JunjianChi/ISCAS_2025_Insole/3d_model/esp32-firebeetle_dfr0478v4_quick-1.snapshot.1/DFR0478V4.png

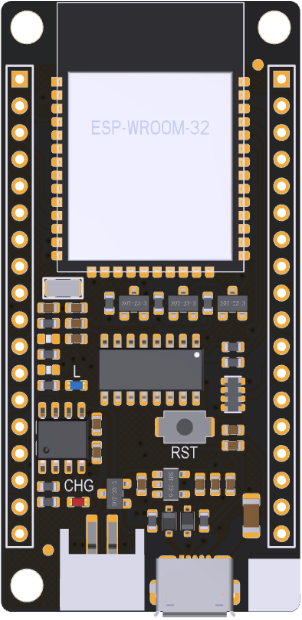
3d_model/esp32-firebeetle_dfr0478v4_quick-1.snapshot.1/DFR0478V4.png
