JunjianChi/ISCAS_2025_Insole/Live_demo_Insole_final.pdf

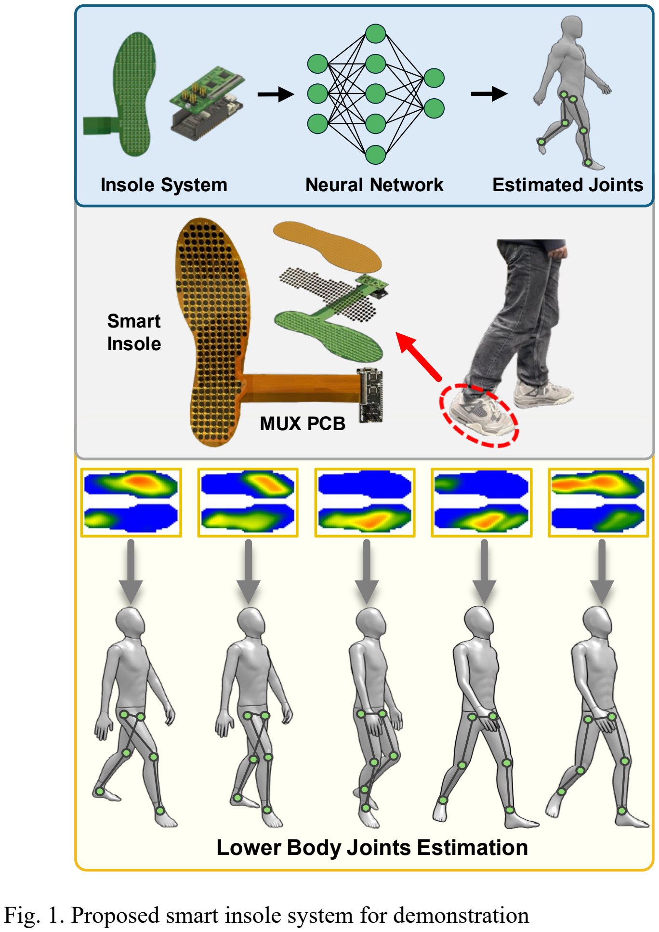
[picture p2: figure]
Insole System; Neural Network; Estimated Joints; Lower Body Joints Estimation; Smart Insole; MUX PCB

Fig. 1. Proposed smart insole system for demonstration

# Live Demonstration: A High-Resolution Plantar Insole System for Lower Body Estimation

JunJian Chi, Qingyu Zhang, Zibo Zhang, Andreas Demosthenous and Yu Wu

Department of Electronic and Electrical Engineering, University College London, Torrington Place, London WC1E 7JE, UK

Email: junjian.chi.22@ucl.ac.uk, yu.wu.09@ucl.ac.uk

Abstract—This work presents a high-resolution plantar
pressure measurement system designed to capture detailed foot information for gait analysis. After training, the customized regression model can estimate lower body joints positions in real-time using foot pressure data. The demonstration will feature a UK size 8 insole, equipped with 253 resistive pressure sensors wirelessly connected to the server. Visitors will have the opportunity to experience walking with the insole, observing the plantar force distribution displayed and lower body joints as predicted by the model on the computer.
I. INTRODUCTION
Gait analysis has been widely carried out with wearable sensors to monitor an individual’s health conditions [1]. The changes of plantar forces distribution during various phases of a walking cycle can identify different body postures and motions. Several researchers have pointed out that these subtle force variations are essential for the prediction of lower body joints movement [2]. Current plantar pressure measurement systems mostly use a limited number of large sensors [3] and tends to neglect details in certain foot areas. Using a denser array of smaller sensors to predict lower limb joint motion has the potential for applications in rehabilitation and sports performance optimisation, though its potential has been relatively underestimated in existing methods [4].
In this demonstration, we present a high-resolution smart insole hardware system, consisting of flexible printed circuit board (FPC) base and a Kapton top layer that sandwiches the circular piezoresistive material (Velostat) as shown in Fig. 1. It can achieve visualization of comprehensive pressure heatmaps on the computer at a fast wireless transmission rate. Combining a customized Convolutional Neural Networks (CNNs) and Long Short-Term Memory (LSTM) model, it can predict six lower body joint landmark positions (left hip, right hip, left knee, right knee, left foot, and right foot) with a high coefficient of determination [5].

II. DEMONSTRATION SETUP AND VISITOR EXPERIENCE
A 253-resolution wireless insole system, an RGB camera and a laptop for predicting lower body estimation from the transmitted pressure data is provided in the demonstration. This demonstration allows visitors to wear the smart insole and observe their lower limb joints prediction through the laptop's GUI. To enhance the visitors' understanding of how the pressure-sensitive insole predicts lower limb dynamics, a classic human skeleton recognition algorithm using an RGB camera will be set up as a comparison group. After completing the experience with the control group, users will wear the smart insole and can observe their lower limb movements in real-time on the GUI. Additionally, a heatmap displaying the plantar pressure distribution will be shown as a reference for visitors.

REFERENCES
[1] Wang, Y. Kim, H. Shin, and S. D. Min, “Preliminary clinical application of textile insole sensor for hemiparetic gait pattern analysis,” Sensors, vol. 19, no. 18, Art. no. 18, Jan. 2019.
[2] Tao, T. Liu, R. Zheng, and H. Feng, “Gait analysis using wearable sensors,” Sensors (Basel), vol. 12, no. 2, pp. 2255–2283, Feb. 2012.
[3] M. Santos, B. B. Gomes, M. A. Neto, and A. M. Amaro, “A systematic review of insole sensor technology: Recent studies and future directions,” Applied Sciences, vol. 14, no. 14, Art. no. 14, Jan. 2024.
[4] A. Ramirez-Bautista, J. A. Huerta-Ruelas, S. L. Chaparro-Cardenas, and A. Hernandez-Zavala, “A review in detection and monitoring gait disorders using in-shoe plantar measurement systems,” IEEE Rev Biomed Eng, vol. 10, pp. 299–309, 2017.
[5] J. Chi, Q. Zhang, Z. Zhang, A. Demosthenous, and Y. Wu “High-Resolution Plantar Pressure Insole System for Enhanced Lower Body Biomechanical Analysis,” submitted to 2025 IEEE Int. Symp. Circuits Syst. (ISCAS 2025, Submission ID: 2728)

This work was supported by the Rosetrees Trust, under grant reference: UCL-IHE-HA\1.
