JunjianChi/ISCAS_2025_Insole/PCB/Insole_ver1_pcb/Insole_ver1.png

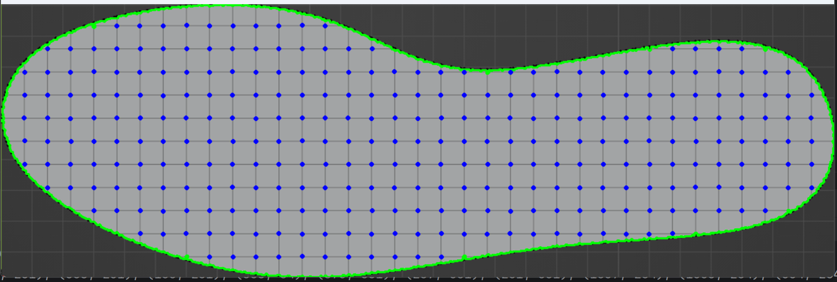
PCB/Insole_ver1_pcb/Insole_ver1.png
