JunjianChi/ISCAS_2025_Insole/Software_Code/plot/sensor_resistance_vs_pressure.png

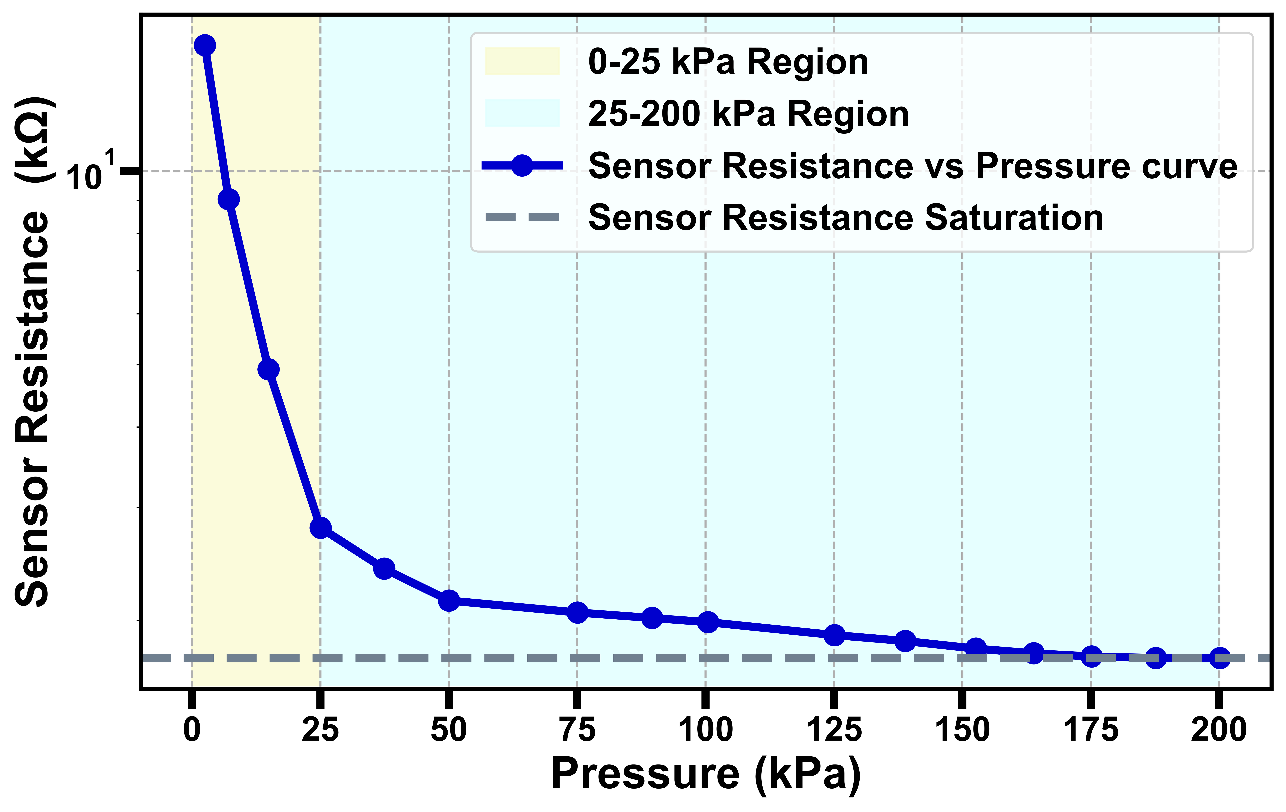
Software_Code/plot/sensor_resistance_vs_pressure.png
