JunjianChi/ISCAS_2025_Insole/PCB/MUX_STACK_ver1/Component/images.png

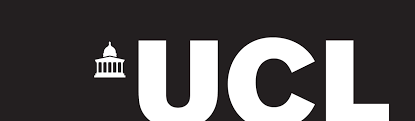
PCB/MUX_STACK_ver1/Component/images.png
