JunjianChi/ISCAS_2025_Insole/3d_model/3.3V 500Mah Battery v2.step

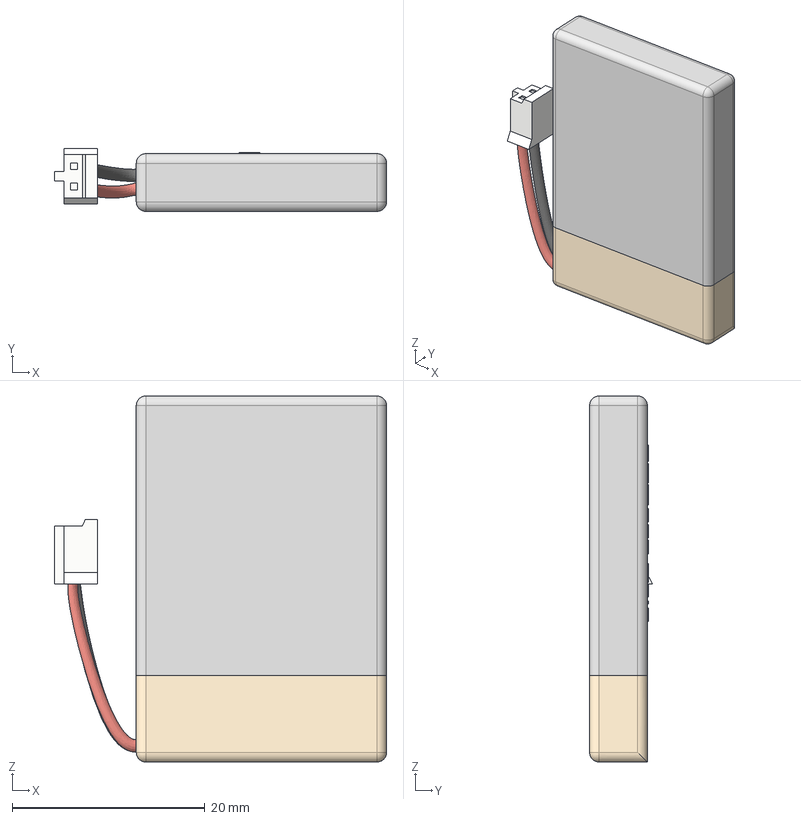
[picture p7: CAD file, 2024-11-11]
3d_model/3.3V 500Mah Battery v2.step
34.5 x 6.52 x 38.0 mm
Black wIRE
Red Wire
Connector
Text
Text (1)
