JunjianChi/ISCAS_2025_Insole/3d_model/esp32-firebeetle_dfr0478v4_quick-1.snapshot.1/ESP32_Firebeetle_DFR0478V4 v7.iges

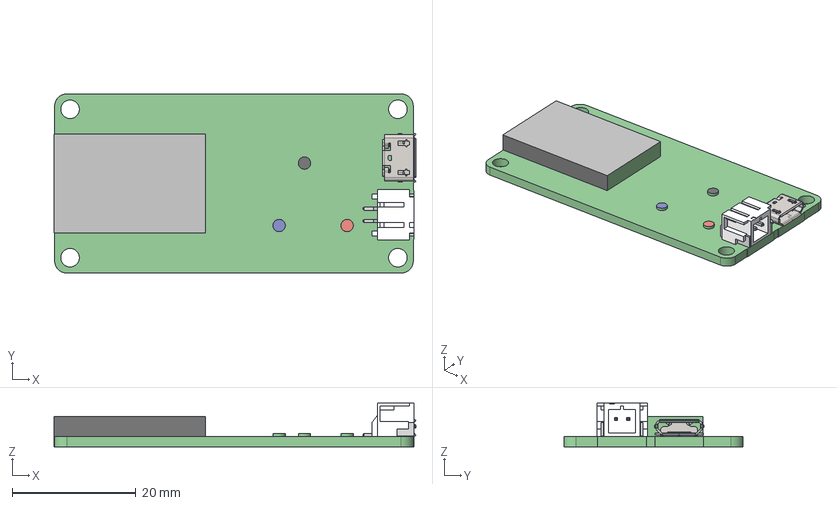
[picture p8: CAD file, 2024-11-11]
3d_model/esp32-firebeetle_dfr0478v4_quick-1.snapshot.1/ESP32_Firebeetle_DFR0478V4 v7.iges
58.5 x 29.0 x 7.08 mm
