JunjianChi/ISCAS_2025_Insole/PCB/MUX_STACK_ver1/Component/LIB_3313J-1-103E/3313J-1-103E/3D/3313J-1-103E.stp

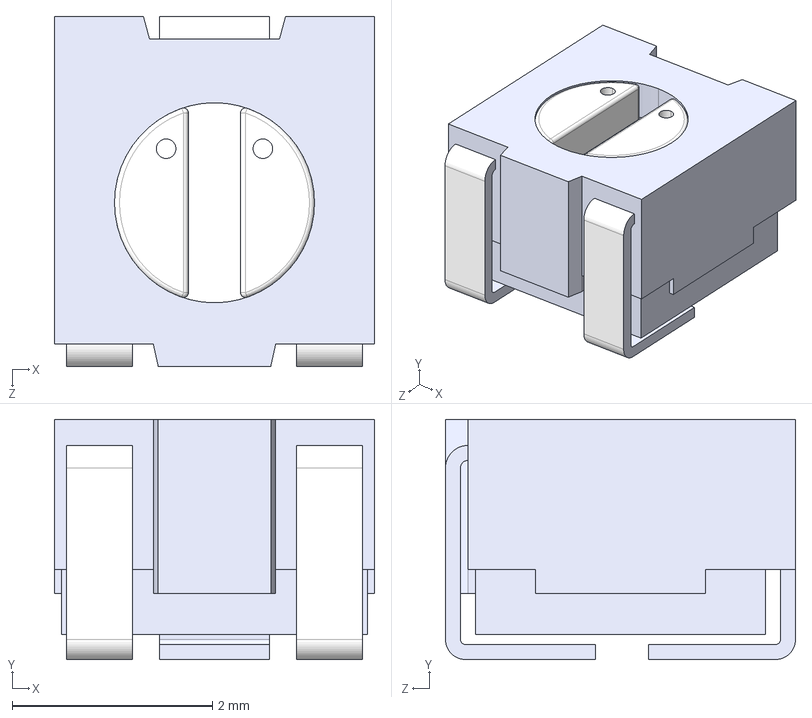
[picture p9: CAD file, 2024-11-11]
PCB/MUX_STACK_ver1/Component/LIB_3313J-1-103E/3313J-1-103E/3D/3313J-1-103E.stp
3.20 x 2.40 x 3.50 mm
