JunjianChi/ISCAS_2025_Insole/PCB/MUX_STACK_ver1/Component/LIB_AD8231TCPZ-EP-R7/AD8231TCPZ-EP-R7/3D/AD8231TCPZ-EP-R7.stp

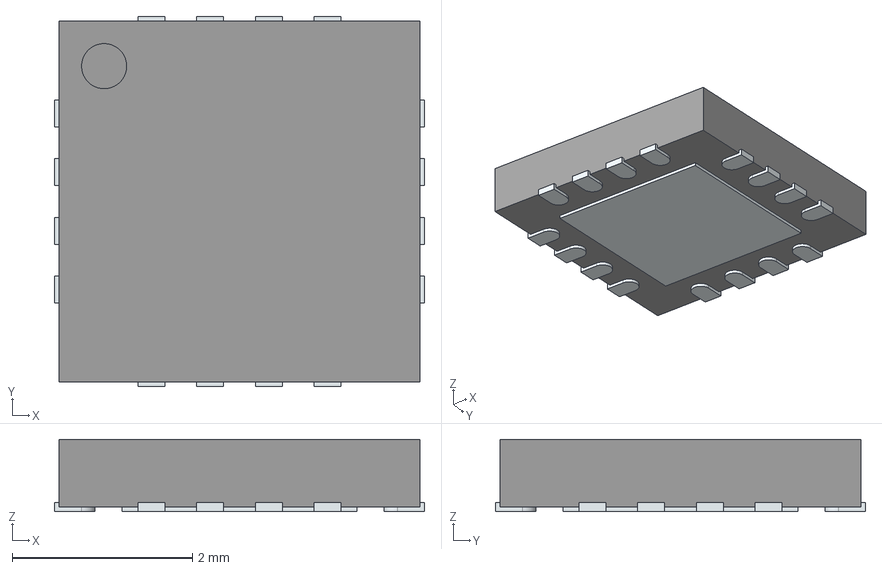
[picture p10: CAD file, 2024-11-11]
PCB/MUX_STACK_ver1/Component/LIB_AD8231TCPZ-EP-R7/AD8231TCPZ-EP-R7/3D/AD8231TCPZ-EP-R7.stp
4.10 x 4.10 x 0.8 mm
ThermalPin
PinsArrayLR
PinsArrayTB
