JunjianChi/ISCAS_2025_Insole/PCB/MUX_STACK_ver1/Component/LIB_AD8615AUJZ-REEL7/AD8615AUJZ-REEL7/3D/AD8615AUJZ-REEL7.stp

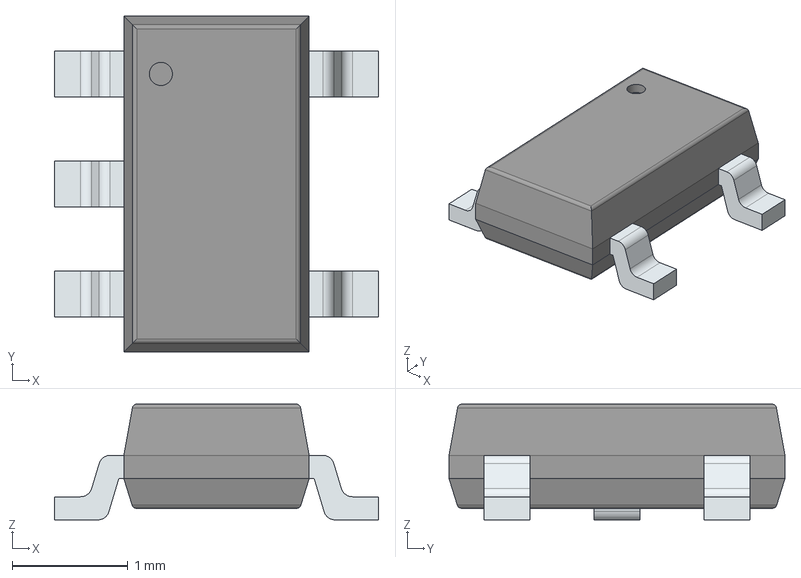
[picture p11: CAD file, 2024-11-11]
PCB/MUX_STACK_ver1/Component/LIB_AD8615AUJZ-REEL7/AD8615AUJZ-REEL7/3D/AD8615AUJZ-REEL7.stp
2.80 x 2.90 x 1.00 mm
PinsArrayL
PinsArrayR
