JunjianChi/ISCAS_2025_Insole/PCB/MUX_STACK_ver1/Component/LIB_ADG732BSUZ-REEL/ADG732BSUZ-REEL/3D/ADG732BSUZ-REEL.stp

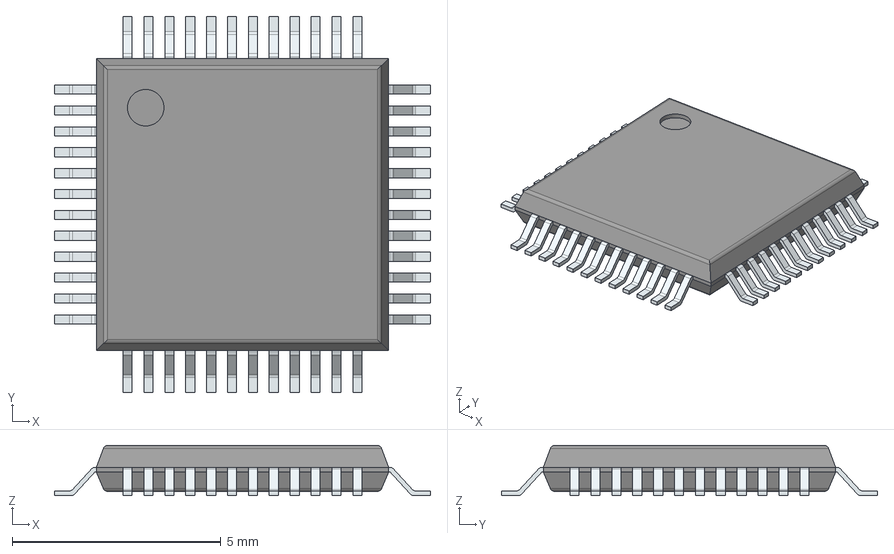
[picture p12: CAD file, 2024-11-11]
PCB/MUX_STACK_ver1/Component/LIB_ADG732BSUZ-REEL/ADG732BSUZ-REEL/3D/ADG732BSUZ-REEL.stp
9.00 x 9.00 x 1.20 mm
PinsArrayLR
PinsArrayTB
