JunjianChi/ISCAS_2025_Insole/3d_model/ADG732BSUZ--3DModel-STEP-269445.STEP

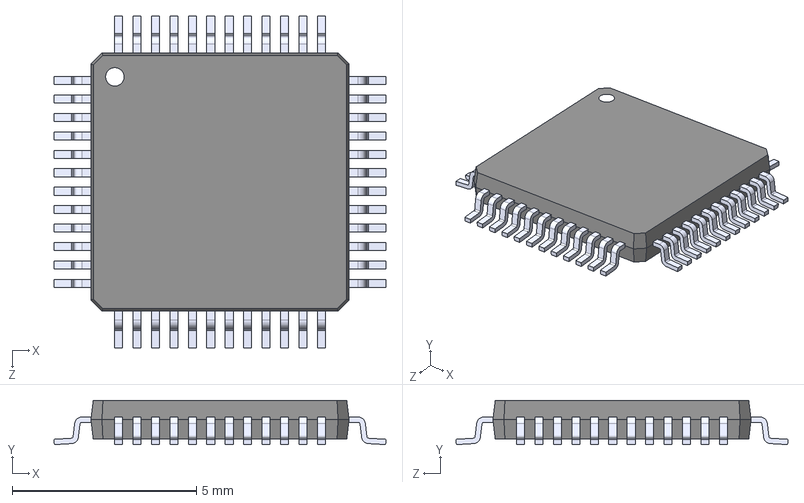
[picture p13: CAD file, 2024-11-11]
3d_model/ADG732BSUZ--3DModel-STEP-269445.STEP
9.00 x 1.20 x 9.00 mm
