JunjianChi/ISCAS_2025_Insole/3d_model/fh28d-64s-0_5sh_05_.stp

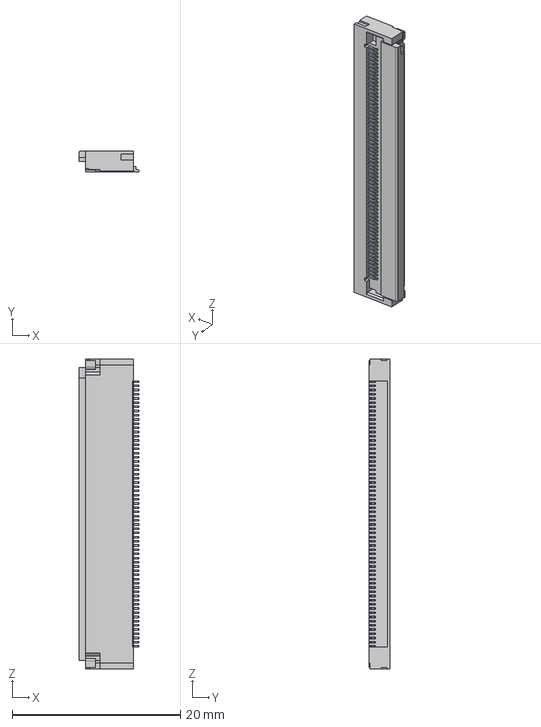
[picture p14: CAD file, 2024-11-11]
3d_model/fh28d-64s-0_5sh_05_.stp
7.20 x 2.55 x 36.9 mm
