JunjianChi/ISCAS_2025_Insole/(list of files, cad)

Other CAD files:
3d_model/esp32-firebeetle_dfr0478v4_quick-1.snapshot.1/ESP32_Firebeetle_DFR0478V4 v6.obj
3d_model/esp32-firebeetle_dfr0478v4_quick-1.snapshot.1/ESP32_Firebeetle_DFR0478V4 v7.dxf
PCB/Insole_ver1_pcb/component_library/LIB_F31L-1A7H1-11040/F31L-1A7H1-11040/Allegro/f31l1a7h111040.psm
PCB/Insole_ver1_pcb/component_library/LIB_F31L-1A7H1-11040/F31L-1A7H1-11040/DEHDL/f31l_1a7h1_11040/chips/chips.prt
PCB/MUX_STACK_ver1/Component/LIB_3313J-1-103E/3313J-1-103E/Allegro/3313j1103e.psm
PCB/MUX_STACK_ver1/Component/LIB_3313J-1-103E/3313J-1-103E/DEHDL/3313j_1_103e/chips/chips.prt
PCB/MUX_STACK_ver1/Component/LIB_AD8231TCPZ-EP-R7/AD8231TCPZ-EP-R7/Allegro/qfn65p400x400x80-17n-d.psm
PCB/MUX_STACK_ver1/Component/LIB_AD8231TCPZ-EP-R7/AD8231TCPZ-EP-R7/DEHDL/ad8231tcpz_ep_r7/chips/chips.prt
PCB/MUX_STACK_ver1/Component/LIB_AD8615AUJZ-REEL7/AD8615AUJZ-REEL7/Allegro/sot95p280x100-5n.psm
PCB/MUX_STACK_ver1/Component/LIB_AD8615AUJZ-REEL7/AD8615AUJZ-REEL7/DEHDL/ad8615aujz_reel7/chips/chips.prt
PCB/MUX_STACK_ver1/Component/LIB_ADG732BSUZ-REEL/ADG732BSUZ-REEL/Allegro/qfp50p900x900x120-48n.psm
PCB/MUX_STACK_ver1/Component/LIB_ADG732BSUZ-REEL/ADG732BSUZ-REEL/DEHDL/adg732bsuz_reel/chips/chips.prt
