JunjianChi/ISCAS_2025_Insole/Experiment_Dataset/standing/ReadME.txt

File name: stand-a-xxx-b
a: 1 FOR right foot ahead of left foot; 2 FOR stand in the same horizontal level
xxx: Person's name
b: Number of sequences

Each sample has recorded for 5 mins, about 1500 frames
