JunjianChi/ISCAS_2025_Insole/Experiment_Dataset/standing/stand_1_cjj_1.csv

Timestamp | Frame | head_x | head_y | head_z | left_shoulder_x | left_shoulder_y | left_shoulder_z | right_shoulder_x | right_shoulder_y | right_shoulder_z | left_elbow_x | left_elbow_y | left_elbow_z | right_elbow_x | right_elbow_y | right_elbow_z | left_hip_x | left_hip_y | left_hip_z | right_hip_x | right_hip_y | right_hip_z | left_knee_x | left_knee_y | left_knee_z | right_knee_x | right_knee_y | right_knee_z | left_heel_x | left_heel_y | left_heel_z | right_heel_x | right_heel_y | right_heel_z | left_foot_index_x | left_foot_index_y | left_foot_index_z | right_foot_index_x | right_foot_index_y | right_foot_index_z | Matrix_0 | Matrix_1
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
