JunjianChi/ISCAS_2025_Insole/PCB/MUX_STACK_ver1/Mux_64pin.pdf

# ADG732BSUZ S¹²

MUX_ROW_S32 MUX_ROW_S¹⁷ MUX_COL_S¹² MUX_COL_S¹¹ MUX_COL_S¹⁰ MUX_COL_S⁹ MUX_COL_S⁸ MUX_COL_S⁷ MUX_COL_S⁶ MUX_COL_S⁵ MUX_COL_S⁴ MUX_COL_S³ MUX_COL_S² MUX_COL_S¹

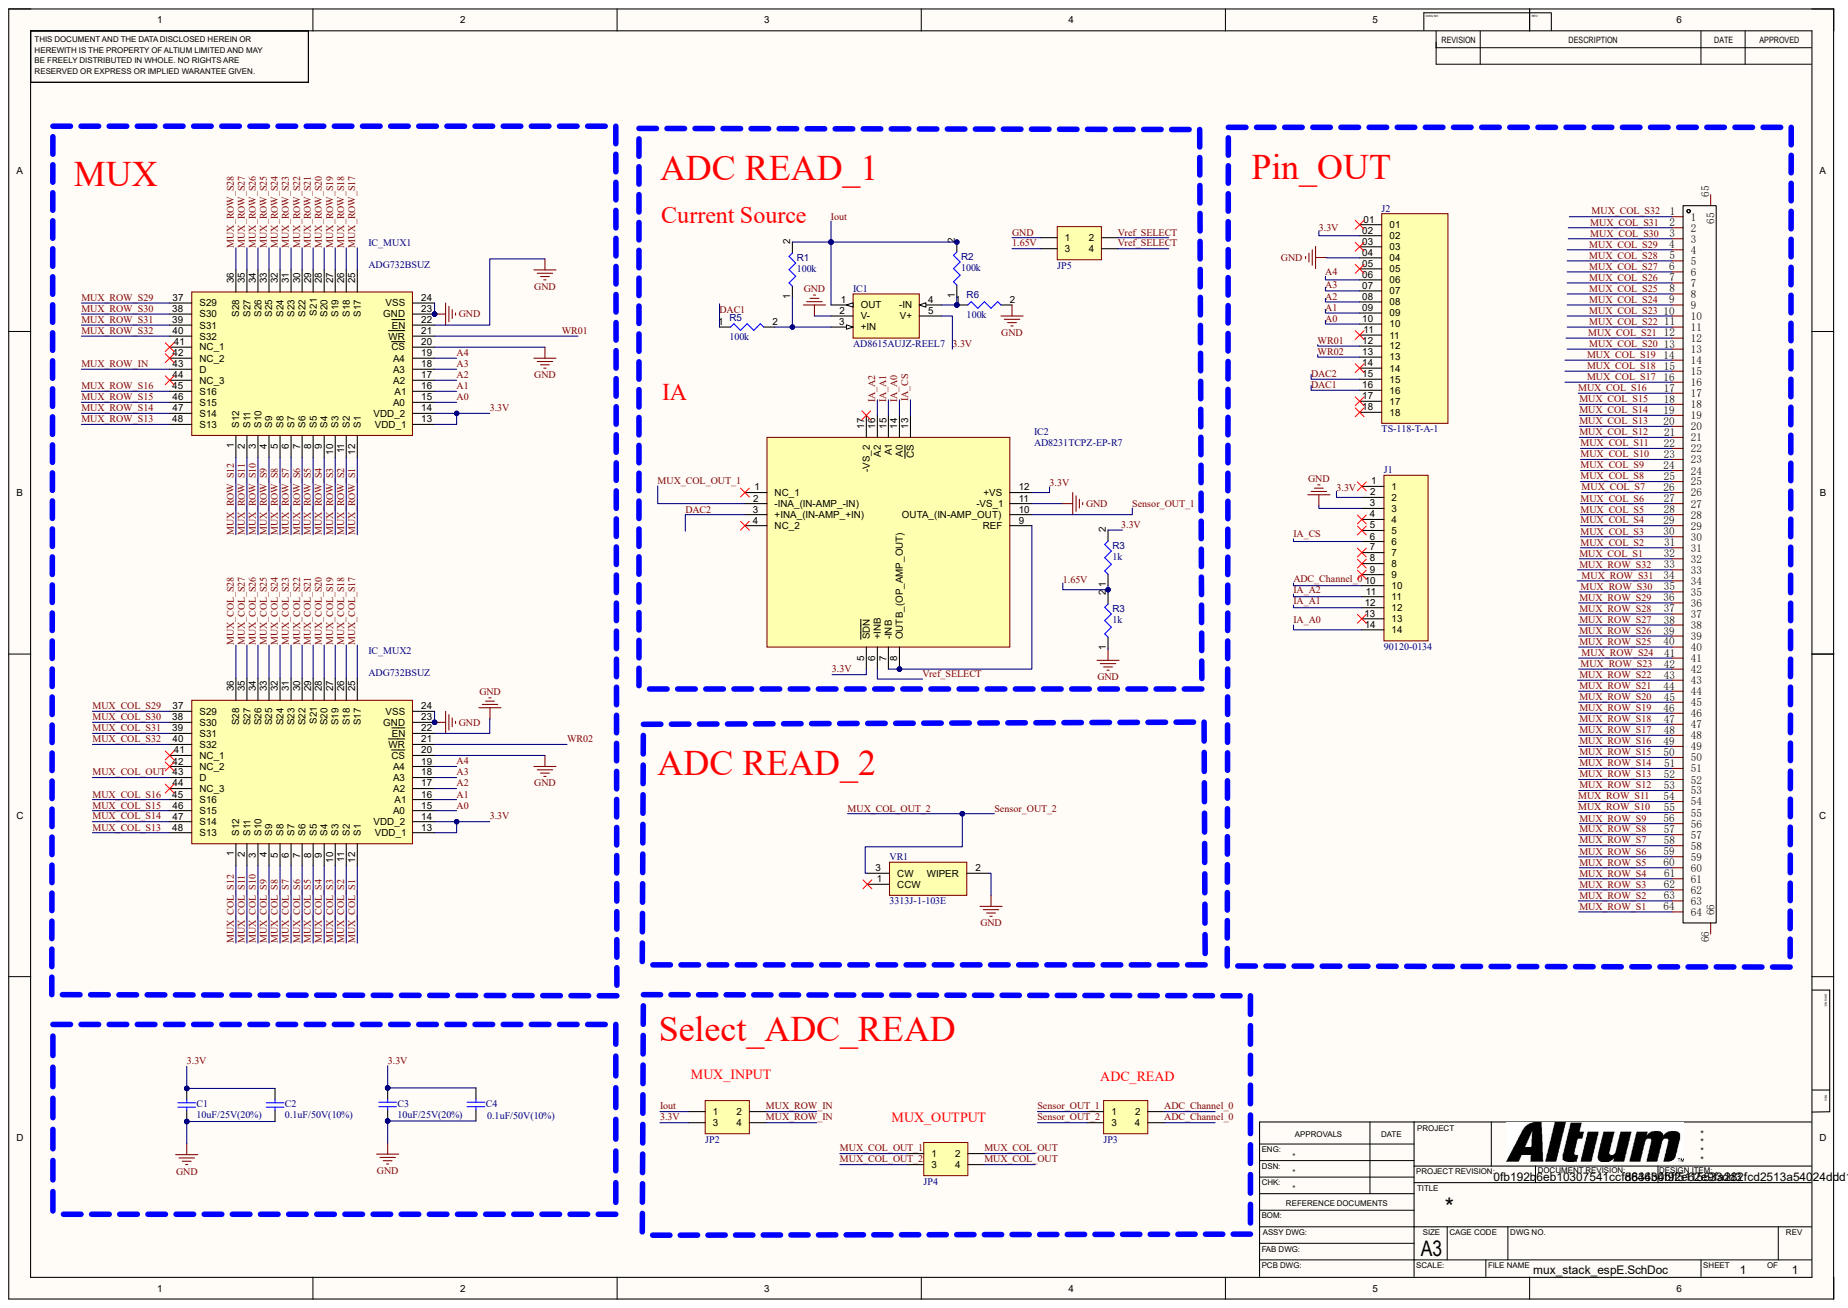
[picture p15: page 1]

1 | 2 | 3 | 4 | 5 | DWG NO: | REV: | 6

THIS DOCUMENT AND THE DATA DISCLOSED HEREIN OR HEREWITH IS THE PROPERTY OF ALTIUM LIMITED AND MAY BE FREELY DISTRIBUTED IN WHOLE. NO RIGHTS ARE RESERVED OR EXPRESS OR IMPLIED WARANTEE GIVEN. | | REVISION | DESCRIPTION | DATE | APPROVED

APPROVALS | DATE | PROJECT | * *

ENG: *
DSN: *
CHK: *
