JunjianChi/ISCAS_2025_Insole/(list of files, drawings)

Other design files:
PCB/Dip_Laser_Cut/Insole_42.dip
PCB/Dip_Laser_Cut/MAT_32.dip
PCB/Insole_ver1_pcb/component_library/LIB_F31L-1A7H1-11040/F31L-1A7H1-11040/Altium/F31L1A7H111040.PcbLib
PCB/Insole_ver1_pcb/component_library/LIB_F31L-1A7H1-11040/F31L-1A7H1-11040/Altium/F31L-1A7H1-11040.SchLib
PCB/Insole_ver1_pcb/component_library/Project Outputs for Free Documents/Free Documents/PCB1_sensor_mat_inso_v1 1.PcbLib
PCB/Insole_ver1_pcb/component_library/Project Outputs for Free Documents/Free Documents/Sheet1_sensor_mat_inso_v1 1.SCHLIB
PCB/Insole_ver1_pcb/Insole_ver1_42.PcbDoc
PCB/Insole_ver1_pcb/Insole_ver1_chi.SchDoc
PCB/MUX_STACK_ver1/Component/8.15A0.0642001_8.15A0.064200.schdoc.schdoc
PCB/MUX_STACK_ver1/Component/FPC-SMD_64P-P0.50_8.15A0.064200.pcbdoc
PCB/MUX_STACK_ver1/Component/FPC_64.PcbLib
PCB/MUX_STACK_ver1/Component/LIB_3313J-1-103E/3313J-1-103E/Altium/3313J1103E.PcbLib
PCB/MUX_STACK_ver1/Component/LIB_3313J-1-103E/3313J-1-103E/Altium/3313J-1-103E.SchLib
PCB/MUX_STACK_ver1/Component/LIB_AD8231TCPZ-EP-R7/AD8231TCPZ-EP-R7/Altium/AD8231TCPZ-EP-R7.SchLib
PCB/MUX_STACK_ver1/Component/LIB_AD8231TCPZ-EP-R7/AD8231TCPZ-EP-R7/Altium/QFN65P400X400X80-17N-D.PcbLib
PCB/MUX_STACK_ver1/Component/LIB_AD8615AUJZ-REEL7/AD8615AUJZ-REEL7/Altium/AD8615AUJZ-REEL7.SchLib
PCB/MUX_STACK_ver1/Component/LIB_AD8615AUJZ-REEL7/AD8615AUJZ-REEL7/Altium/SOT95P280X100-5N.PcbLib
PCB/MUX_STACK_ver1/Component/LIB_ADG732BSUZ-REEL/ADG732BSUZ-REEL/Altium/ADG732BSUZ-REEL.SchLib
PCB/MUX_STACK_ver1/Component/LIB_ADG732BSUZ-REEL/ADG732BSUZ-REEL/Altium/QFP50P900X900X120-48N.PcbLib
PCB/MUX_STACK_ver1/mux_stack_espE.SchDoc
PCB/MUX_STACK_ver1/mux_stack_espE_64pin.PcbDoc
PCB/MUX_STACK_ver1/Simulation_circuit/ADC_test_circuit.ms14
PCB/MUX_STACK_ver1/Simulation_circuit/Design2.ms14
